PubInv/tetrobot/README.md

# gluss

An attempt to build metamorphic robots based on linear actuators. You probably want to go [https://pubinv.github.io/gluss/](https://pubinv.github.io/gluss) first.
