PubInv/tetrobot/doc/WaveletsForGluss.tex

\documentclass[11pt]{article}
\usepackage{geometry} % see geometry.pdf on how to lay out the page. There's lots.
\usepackage{hyperref}
\usepackage{graphicx}
\usepackage{gensymb}
\usepackage[affil-it]{authblk}
\usepackage[toc,page]{appendix}
\usepackage{pifont}
\usepackage{amsmath}
\usepackage{draftwatermark}
\usepackage{listings}

\SetWatermarkText{DRAFT}
\SetWatermarkScale{6}
\SetWatermarkLightness{0.95}

% \geometry{letter} % or letter or a5paper or ... etc
% \geometry{landscape} % rotated page geometry

% See the ``Article customise'' template for come common customisations

\title{Wavelets for Gluss Robots}
\author{Robert L. Read
  \thanks{read.robert@gmail.com}
}
\affil{Founder, Public Invention, an educational non-profit.}

\date{\today}

%%% BEGIN DOCUMENT
\begin{document}

\maketitle

%% \tableofcontents

\section{Introduction}

This is a draft of an attempt to apply wavelet technology to gluss.
However, it may touch on pure and applied mathematics in different valuable ways.
\begin{itemize}  
\item We will argue that wavelet and Fourier transforms should be reformulated to
  accept the possibility a function being undefined at various points. Possibly we will
  learn later that this is wrong, but must provide a means of dealing with it.
\item We will argue that the tendency to treat solid objects as a curved surface in 3-space
  is insufficient for the specific purpose of mapping abstractly from objects to gluss gaits
  and for doing form-matching in three space.
\item We will argue that wavelets provide an ideal way to define gaits for robots,
  not as a transform, but as the original means for constructing and representing them.
\item We will argue that wavelets provide a means of matching solid shapes in both space and time.
\end{itemize}  

\section{Solid Shape Matching Via Wavelets}

A fundamental problem posed by an attempt to create a metamorphic material is how to specify and controls
its shape in both space and time. Ordinarily we would refer to the change in shape over time as a ``gait''
if its purpose is to locomote.

Gluss consists of a number of actuators connected by joints.  Likewise tensegrity robots might consist
of very numerous colletions of struts connected via cables. Whether we consider a moving robot or
a static structure, we would like to conveniently compute a configure of a such machines to match
any solid shape.

It is typical to operate in terms of surfaces. However, we argue it is far better to use three-dimensional
objects directly. It is entirely reasonable to create a general shape in 3-space as a collection of
objects which are not in fact in any way connected, and yet still compute a matching shape of a
connected gluss.  Or, if dealing with a robot swarm, we might even relax the constraint that the result
be connected.

Our fundamental problem is to compute a mapping from what we might call the ``Blob Space'', $\mathcal{B}$, into
the ``Gluss Space'', $\mathcal{G}$. The properties of the the Blob Space are:
\begin{itemize}  
\item It should be really easy for human beings to design objects in $\mathcal{B}$.
\item It should be easy to import representations of objects into $\mathcal{B}$.
\item It should be easy to animate objects in $\mathcal{B}$ without constraints imposed by
  the physical world.  For example, motion need not be continuous and mass need not be conserved.
\item It is untainted by any notion of scale.
\end{itemize}  

The Gluss Space, on the other hand:
\begin{itemize}  
\item Imposes strict limitations on geometry to match the physical limitations of actual robots.
\item An object in $\mathcal{G}$ can be directly implemented with a simulation or a physical robot.
\item Furthermore time may have limits as well. Motion in $\mathcal{G}$ must be continuous, and
  might have to be slow.
\end{itemize}  

Let us consider an example.  We wish to explore the possibility of making a gluss-style robot
walk to  building and crawl through a window. This is requires locomotion, elevation, and
potentially decreasing the size of the robot to fit the window.  Even if the glussbot can
jump through the window, it must potentially deal with these issues, and we may plausible
assume that it will crawl through the window instead, like a worm.

It would be convenient to model the gluss bot as 6 or 7 spheres in $\mathcal{B}$ of the same size.
These need not really be connected, they should just be close enough that they generally form
a stout worm, or grub-like, shape.  Then we develop a short series of steps on $\mathcal{B}$, not
even a smooth animation, that suggests getting through the window. Let us imagine 10 such steps.
This could probably be done in 3 minutes using a mouse and some javascript code.

Then we want to specify a Gluss Space matching a glussbot we actually have. We would like
to automatically map the Blob Space steps into a Gluss Space motion that potentially gets our
glussbot through the window.

It is possible that work done in animation will assist us greatly in this already; I need
to research that.

Assuming this is not already a solved problem, I claim that 3D wavelets are the best way
to approach the mapping problem.

A second example.  In order to give wonder to a child, we want to order our glussbot to
assume the shape of a lion. We import an .stl file into the Blob Space.  But we have a highly
constrained gluss bot.  We have to figure out how to order it to approximate the lion shape.
This problem could be approached as a problem of conformity to an outside surface, but I think
it will be easier when approached as a problem of matching masses described as 3D wavelets.

\subsection{On the problem of 3D wavelets}

I suspect it is an open question how to best define 3D wavelets.
As always, wavelet choice is a design spectrum that depends on the algorithms you wish to use.

It seems to me the fundamental question is whether a wavelet should represent a density function,
upon which a isovalued surface defines solidity, or if it should be digital, having a hard surface.

If it has a hard surface, how do we create negative wavelets?  Dare we use some analog of complex
numbers?  And is this really a 3D problem after all?  If we deal with the problem of undefined
values in a 1-D signal, we have the same problem.

I can imagine that it is intellectually quite interesting to try to design good 3D wavelets.
Indeed even 2D.  Imagine in 2D that we wish to represent not IMAGES but DRAWINGS.

\section{On a human algebra of Wavelets for Gaits}

It is important to understand that it is painful to define gaits in general. Although
it seems mathematical, it may actually be much easier to define an Abelian algebra over gaits,
so that gaits (or wavelet gaits) can be composed by an operation that we call ``addition''.

For example, we want to say to a dancer: ``Walz with the same steps, but hold your hands
above your head.'' This requires the dancer to subtly adjust their gait, such that an observer
might not even notice.  If we say to a gluss: ``hold the baby and carry it to safety'', we
may imagine that to be a radical change to the gait.  Simple composition may not be sufficient.

Nonetheless we should seek a simple composition of gaits.
Untitled event
What seems like a simple approach is to define a gait as a set of wavelets in the space
of actuator controls.  That is, a 12-dimensional space, in the case of the 3TetGlussBot.

\section{On the problem of controlling a gluss}

When the number of actuators in a gluss is measured in 10s, it is reasonable to build a computer simulation
that drags actuators, nodes, of the centroids of tetrahedra to directly.
Eventually, however, we need to control the gluss with manipulation of a simpler system.
For example, we would like to control a tentacle with 8 control nodes, independent of the scale of the
gluss implementing it.

I believe a reasonable approach here is to write an algorithm that takes a model in the ``Blob Space''
and computes a configuration in the ``gluss space''.

Here is such an algorithm (2-D Algorithm, easily generalized):

\begin{lstlisting}
  F(Model,Ape) {
    CM = Centroid(Model);
    If Ape has one triangle or less:
    Attach springs from each node to the centroid of Model
    Else:
    AM = Centroid(Ape);
    MomApe = Moment(Ape);
    MomMod = Moment(Model);
    ApeBifurcationLine = PerpendicularMidpointLine(AM,MomApe);
    ModBifurcationLine = PerpendicularMidpointLine(CM,MomMod);
    return Union(F(Top(Model,ModBifurcationLine),Top(Ape,ApeBifurcationLine)),
                 F(Bot(Model,ModBifurcationLine),Bot(Ape,ModBifurcationLine)));
  }
\end{lstlisting}

The basic ideas is that this computes a set of springs, which when computed by a physics engine, should
do a pretty good job Aping the model with Gluss space with a configuration of the Ape.

I'm not too happy with this as an algorithm. It is not that easy to say very much meaningful about it.
I would like to create an error metric, and prove a relationship between the Error(F(Model,Ape),Model).

I believe it is possible to create an analog of wavelets to allow multiresolution computation, but
have not yet been able to produce any particularly valuable result.

\section{On interesting Dyanmics}

This section probably has nothing to do with dynamics, it is just an interesting idea.

Suppose that we have a gluss system, in the form of tentacle.  Let's imagine it is just in two
dimensions for now.

How fast can we launch a payload? How fast can we throw something?

Note that we can think of this problem in terms of kinematics (which is kind of a cheap shot,
and unlikely to be successful) just based on the motion of the actuators, assuming they are always
strong enough to produce the velocities in question.

Or we can work on it from the point of view of dynamics, which makes it much more interesting.

A gluss tentacle that could toss things would be pretty astounding.

\section{Thoughts on Wavelets}

Over the week will traveling I made a number of attempts to develop a theory of
Blob Spaces.

There are several approaches:
\begin{itemize}  
\item We can create a ``moment-based'' system.
\item We can try to build a ``simplex'' based system that uses triangles/tetrahedra.
\item We can beuild an ``extent-based'' system.
\end{itemize}

I made copious notes with many ideas but came to no particular conclusion.
However, I am convinced that we need a software toolchain and that the basic ideas of
Blob theory are needed.

Note that I need to do a lot more research in animation to understand this.

My notes suggest that there are rich possibilities, but I found no crisp
theorems or ideas.

One idea is to separate the physical interpretation from the data space.

Resarch ``Fresh'' and 2D animation.
3D Animation seems to be done with Blender or ``Maya'' and rigging and keyframes.
Motion Graphics is next form.

\end{itemize}  

\end{document}
