PubInv/tetrobot/doc/TurretJointPieces.pdf

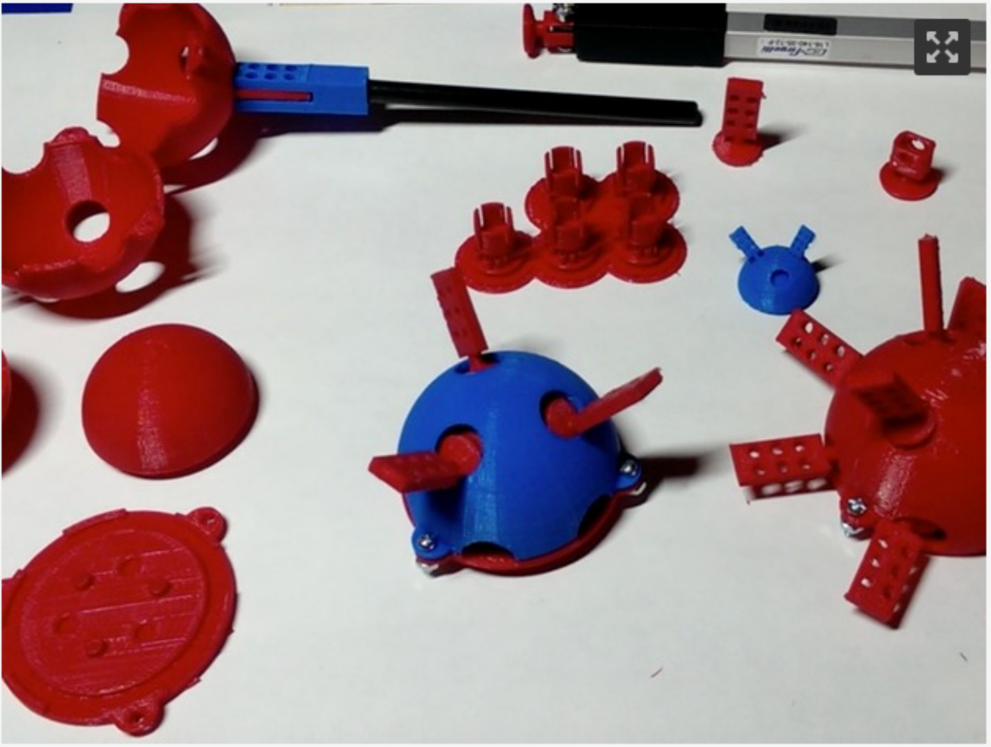
[picture p31: page 1]
