PubInv/tetrobot/doc/5TetGlussBotPictures/DSC_0990.JPG

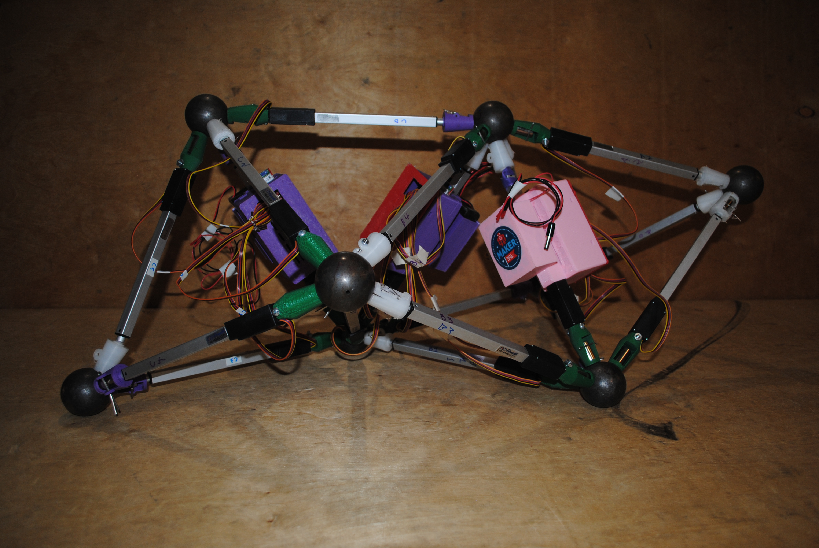
doc/5TetGlussBotPictures/DSC_0990.JPG
