PubInv/tetrobot/doc/5TetGlussBotPictures/DSC_0991.JPG

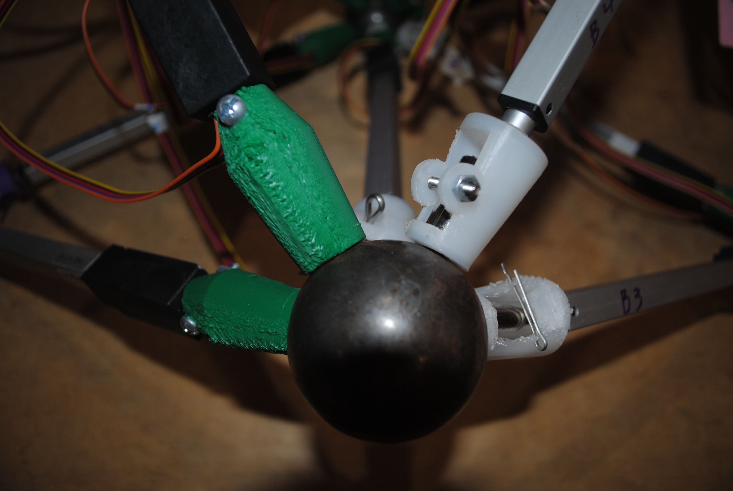
doc/5TetGlussBotPictures/DSC_0991.JPG
