PubInv/tetrobot/doc/5TetGlussBotPictures/DSC_0992.JPG

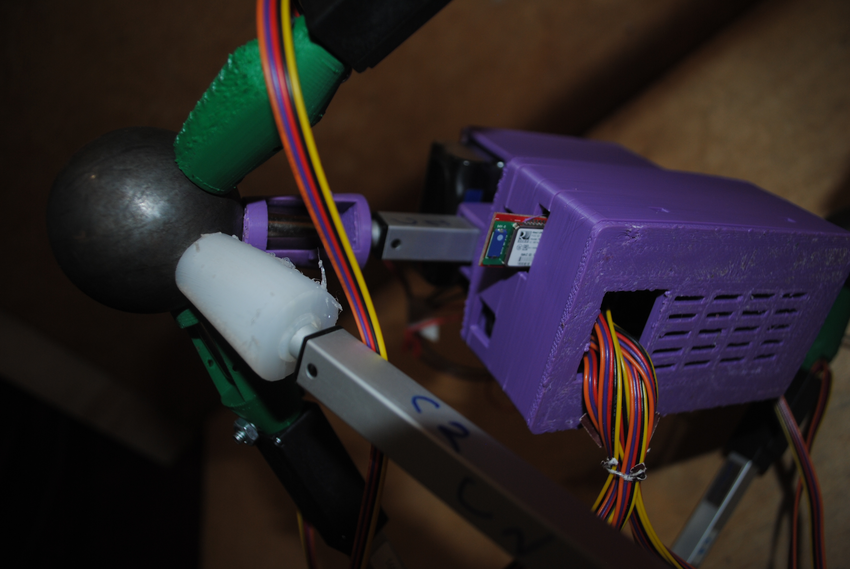
doc/5TetGlussBotPictures/DSC_0992.JPG
