PubInv/tetrobot/doc/5TetGlussBotPictures/DSC_0994.JPG

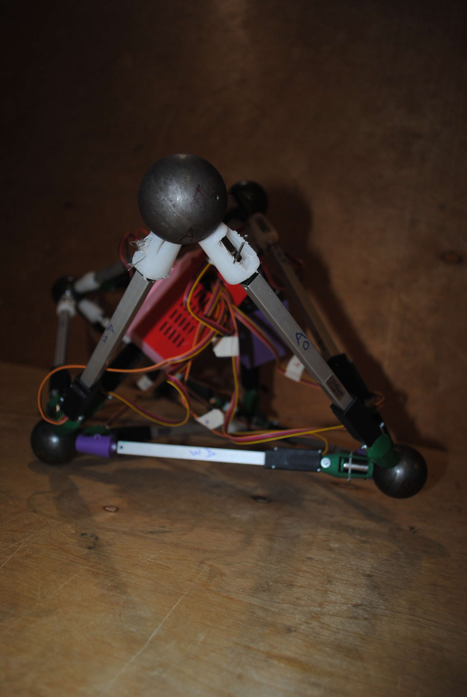
doc/5TetGlussBotPictures/DSC_0994.JPG
