PubInv/tetrobot/doc/5TetGlussBotPictures/DSC_0996.JPG

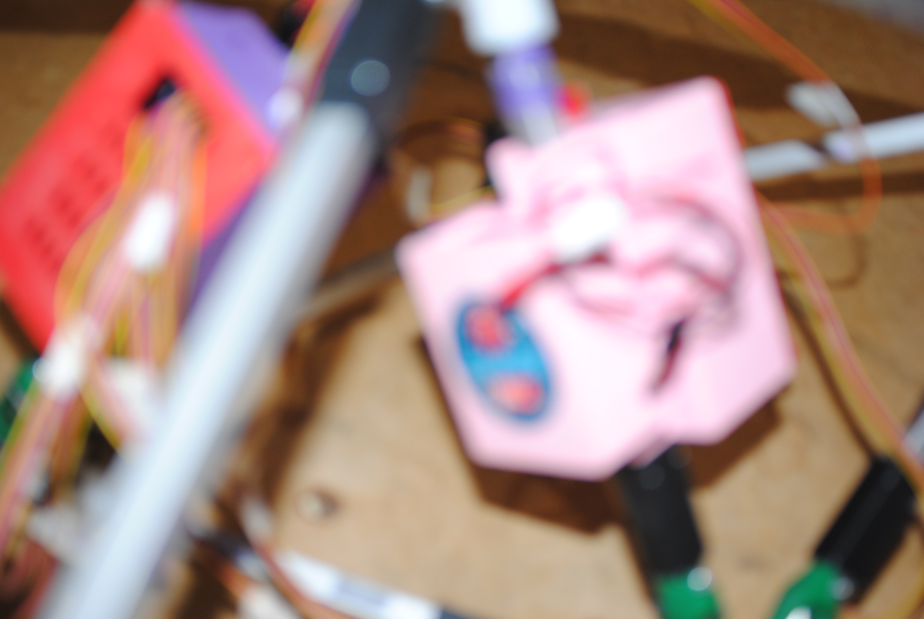
doc/5TetGlussBotPictures/DSC_0996.JPG
