PubInv/tetrobot/doc/5TetGlussBotPictures/DSC_0998.JPG

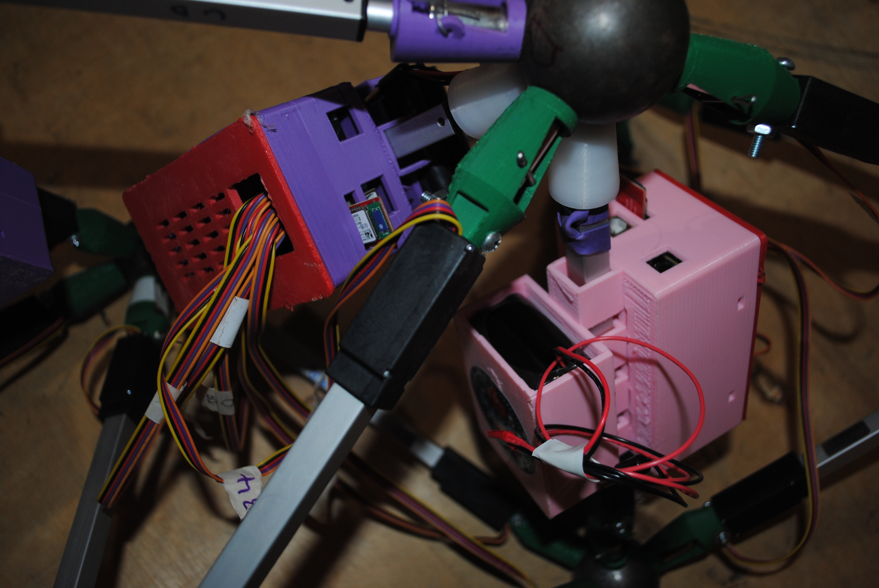
doc/5TetGlussBotPictures/DSC_0998.JPG
