PubInv/tetrobot/doc/Coxeter_helix_3_colors_cw.png

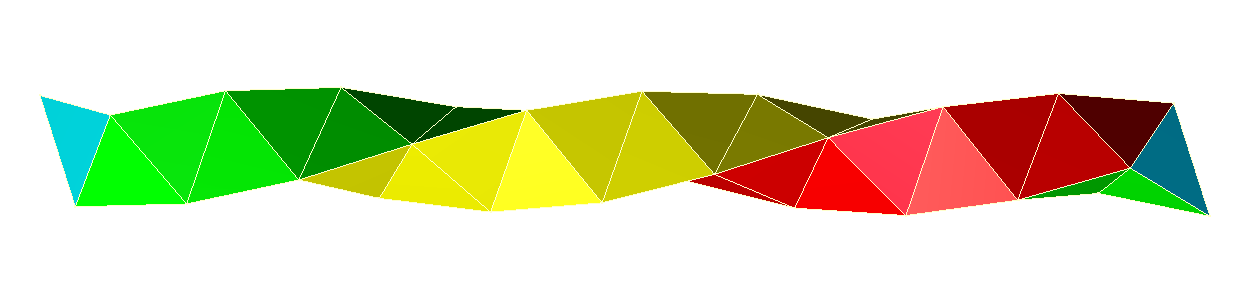
doc/Coxeter_helix_3_colors_cw.png
