PubInv/tetrobot/doc/figures/Tetrahelix0.png

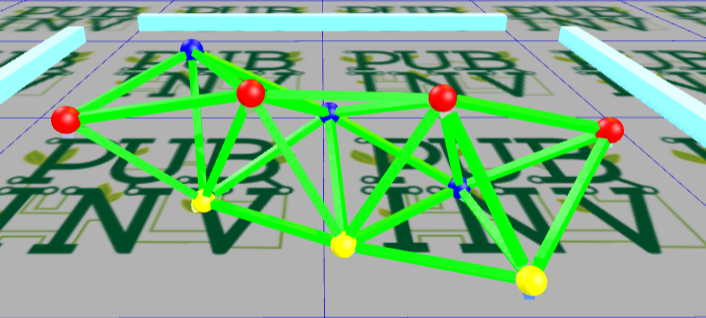
doc/figures/Tetrahelix0.png
