PubInv/tetrobot/doc/figures/Tetrahelix1.png

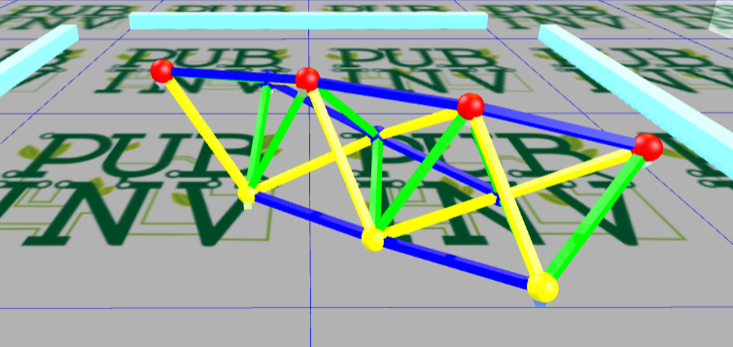
doc/figures/Tetrahelix1.png
