PubInv/tetrobot/doc/figures/Tetrahelix2.png

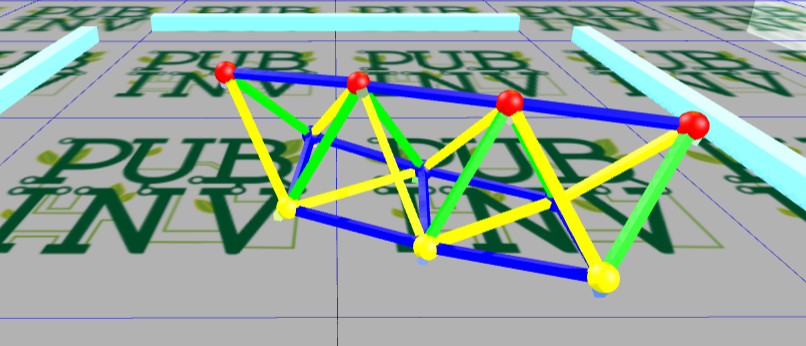
doc/figures/Tetrahelix2.png
