PubInv/tetrobot/doc/figures/Tetrahelix3.png

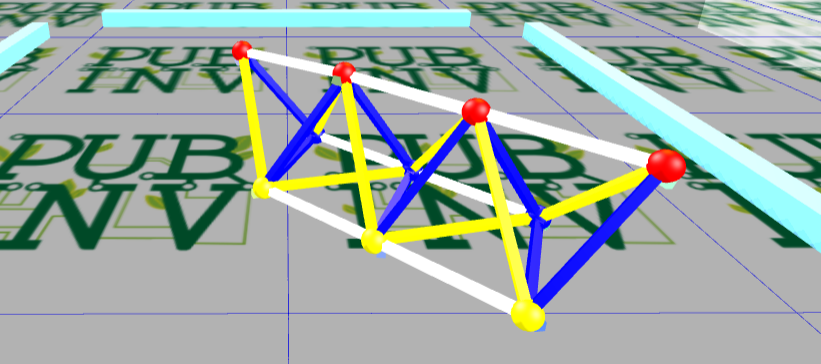
doc/figures/Tetrahelix3.png
