PubInv/tetrobot/doc/figures/TetrahelixColoringDiagram.png

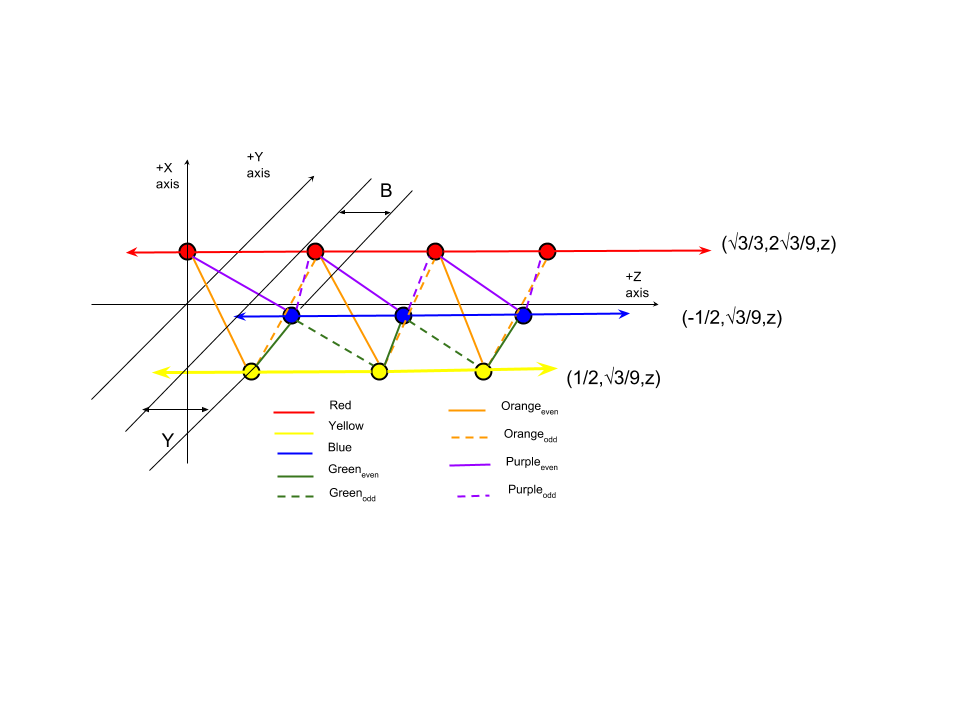
doc/figures/TetrahelixColoringDiagram.png
