PubInv/tetrobot/doc/Kwon, Song, Kim Screenshot.png

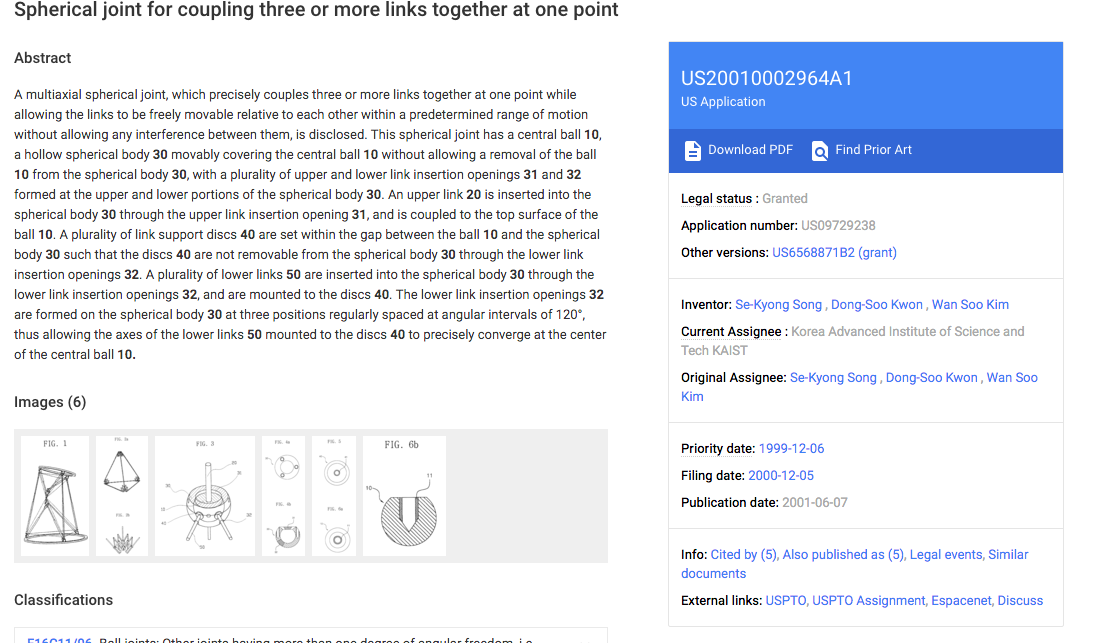
doc/Kwon, Song, Kim Screenshot.png
