PubInv/tetrobot/doc/TetrahelixColoringDiagram.png

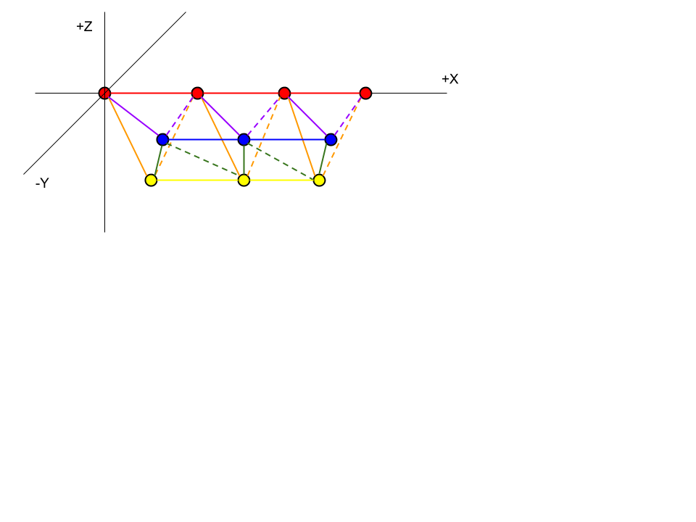
doc/TetrahelixColoringDiagram.png
