PubInv/tetrobot/doc/TurretJointMath.png

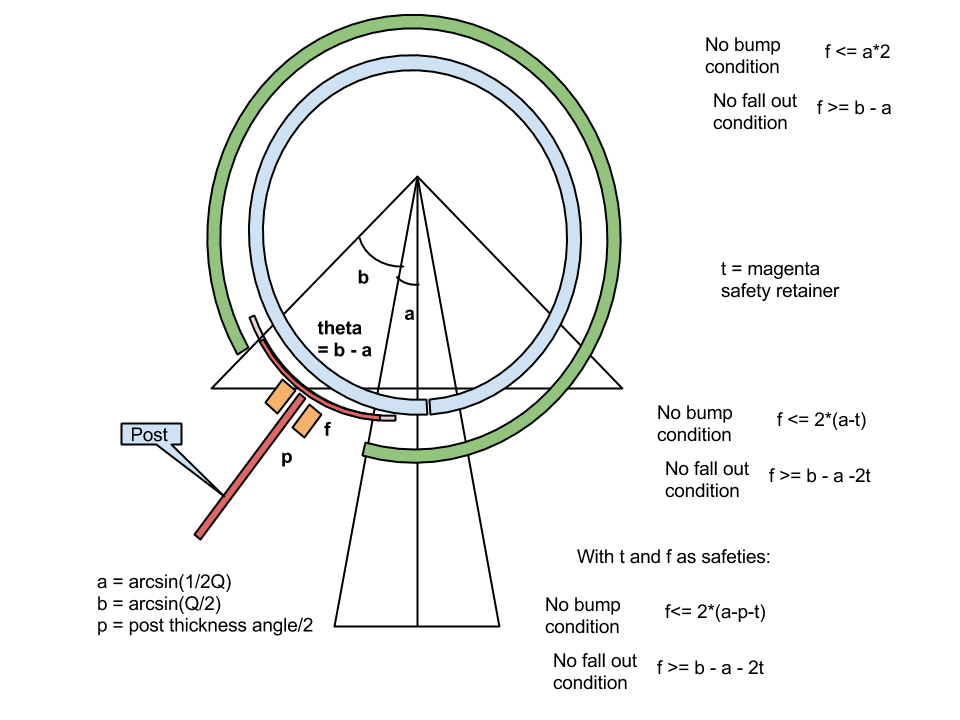
doc/TurretJointMath.png
