PubInv/tetrobot/MegaAndShieldEnclosure/Try2.stl

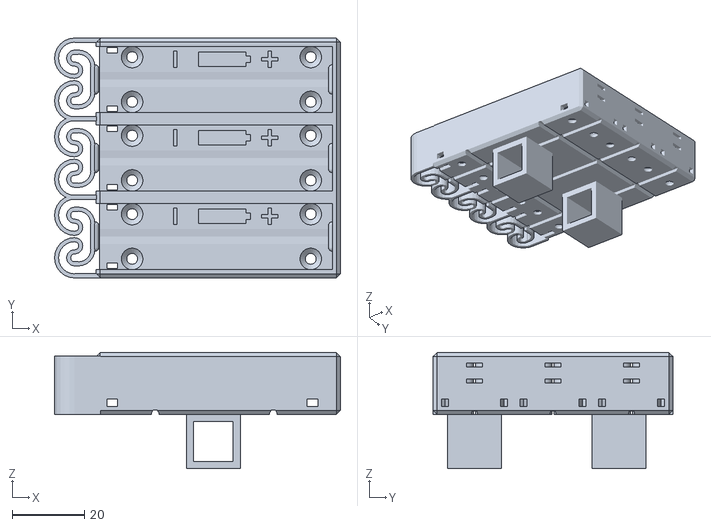
[picture p47: CAD file, 2017-03-30]
MegaAndShieldEnclosure/Try2.stl
79.3 x 66.5 x 32.2
