PubInv/tetrobot/MegaAndShieldEnclosure/combined_enclosure.stl

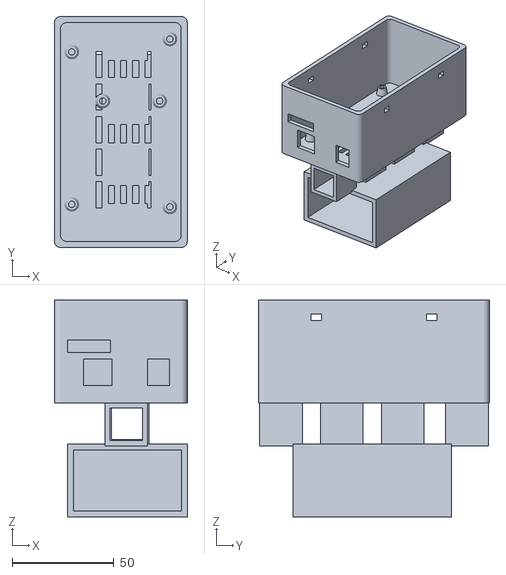
[picture p48: CAD file, 2017-03-30]
MegaAndShieldEnclosure/combined_enclosure.stl
65.5 x 113.6 x 106.7
