PubInv/tetrobot/MegaAndShieldEnclosure/EnclosureLid.stl

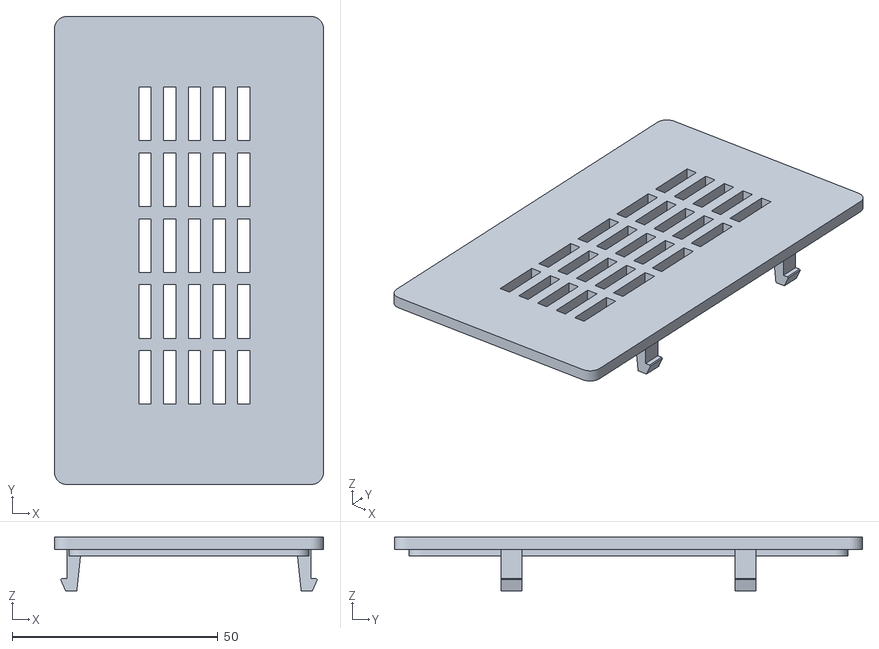
[picture p49: CAD file, 2017-03-30]
MegaAndShieldEnclosure/EnclosureLid.stl
65.3 x 113.6 x 13.0
