PubInv/tetrobot/MegaAndShieldEnclosure/BatteryCase.stl

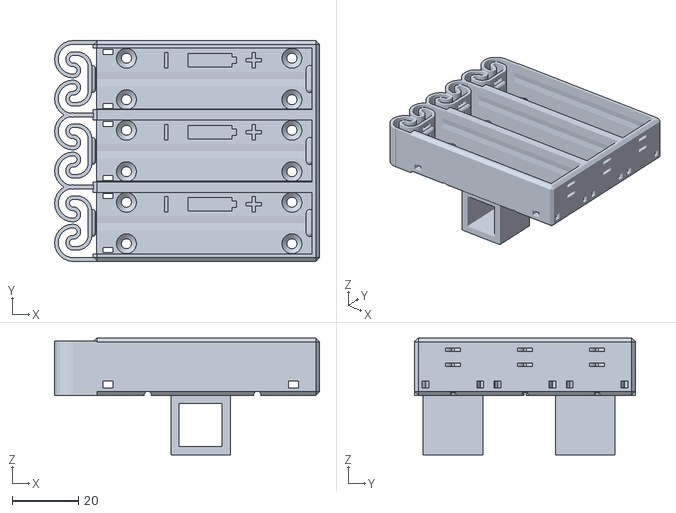
[picture p50: CAD file, 2017-03-30]
MegaAndShieldEnclosure/BatteryCase.stl
80.1 x 66.7 x 35.3
