PubInv/tetrobot/MegaAndShieldEnclosure/LidWPort.stl

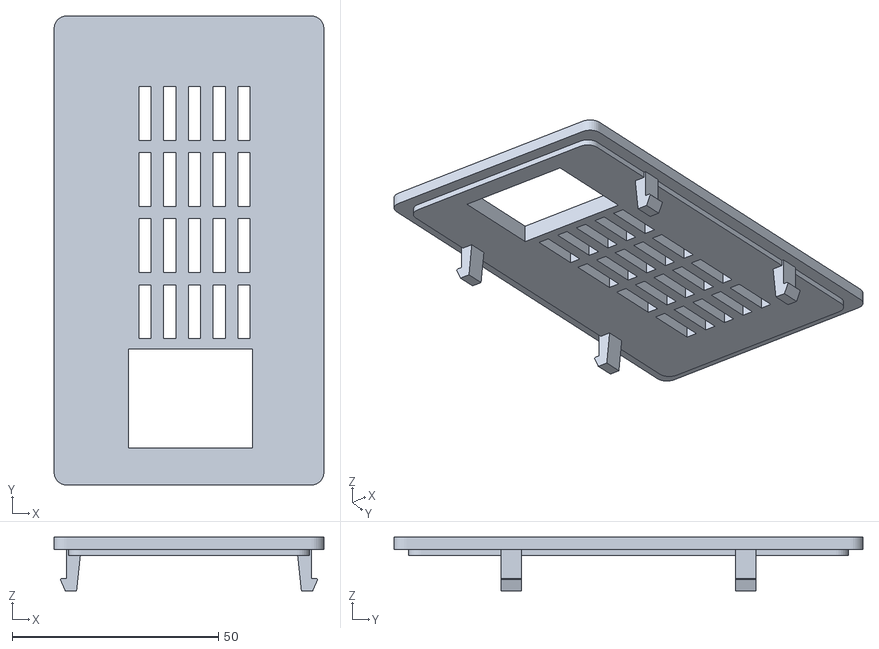
[picture p51: CAD file, 2017-03-30]
MegaAndShieldEnclosure/LidWPort.stl
65.3 x 113.6 x 13.0
