PubInv/tetrobot/MegaAndShieldEnclosure/firg-flexbatter.stl

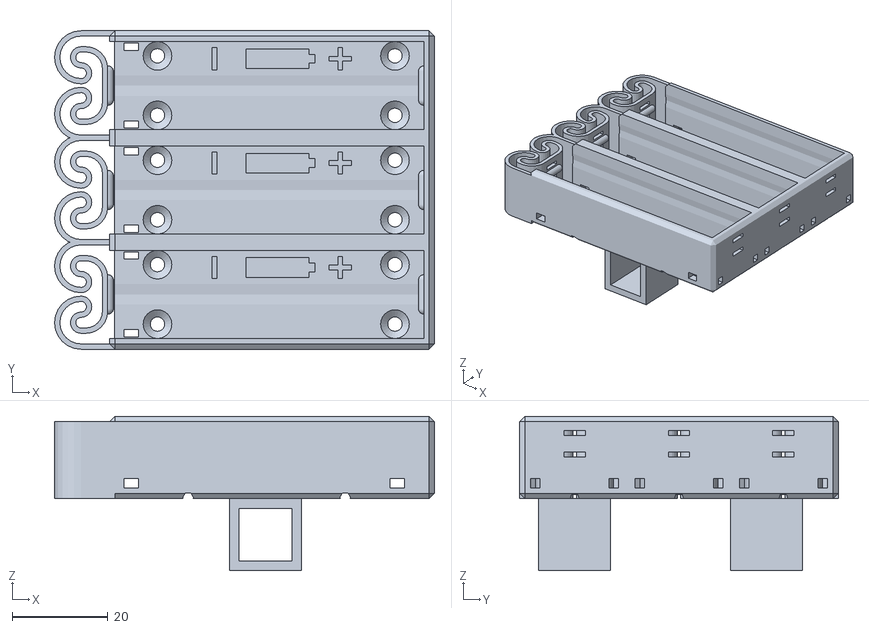
[picture p52: CAD file, 2017-03-30]
MegaAndShieldEnclosure/firg-flexbatter.stl
79.2 x 66.4 x 32.2
