PubInv/tetrobot/MegaAndShieldEnclosure/NiMhHolder.stl

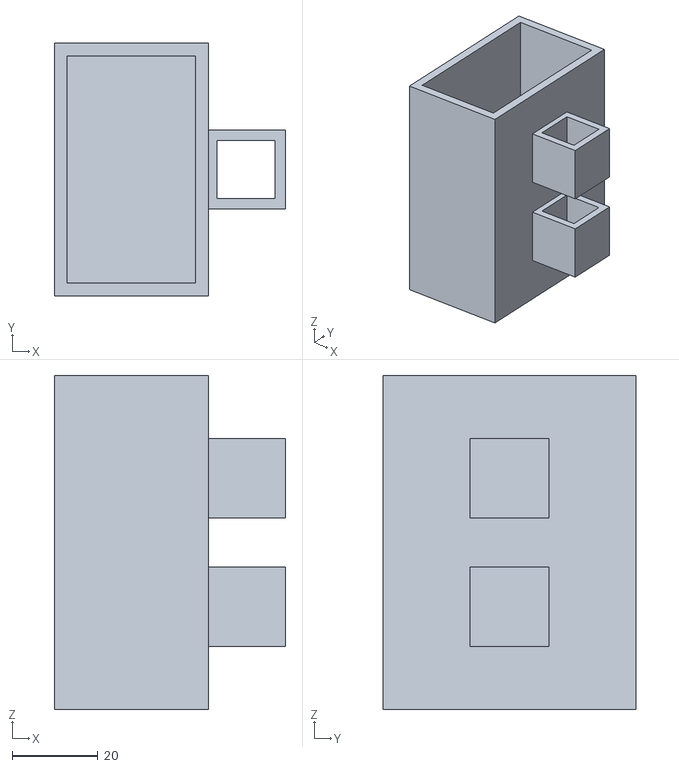
[picture p53: CAD file, 2017-03-30]
MegaAndShieldEnclosure/NiMhHolder.stl
54.0 x 59.0 x 78.0
