PubInv/tetrobot/MegaAndShieldEnclosure/EnclosureWithShield.stl

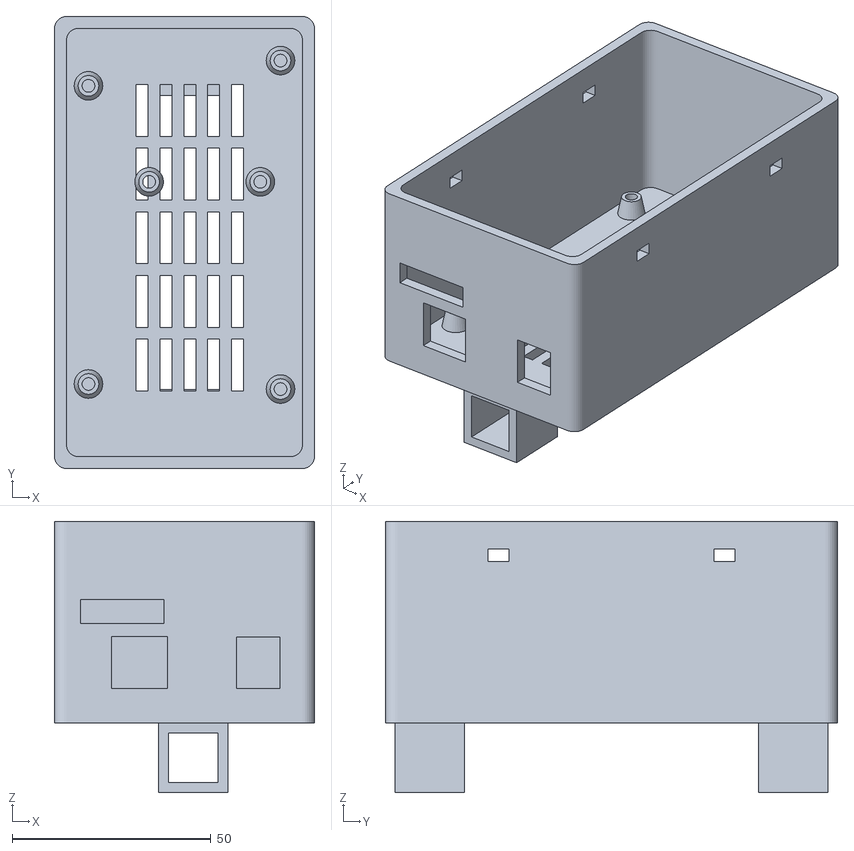
[picture p54: CAD file, 2017-03-30]
MegaAndShieldEnclosure/EnclosureWithShield.stl
65.3 x 113.6 x 68.2
