PubInv/tetrobot/MegaAndShieldEnclosure/CaseBracket.stl

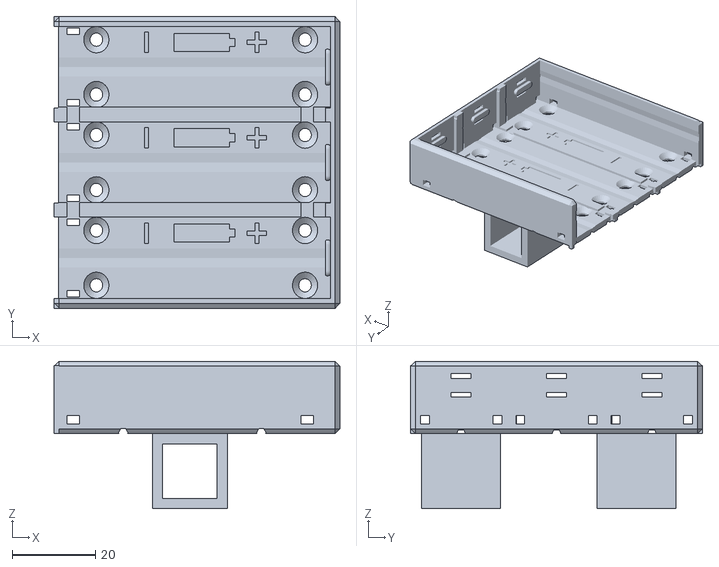
[picture p55: CAD file, 2017-03-30]
MegaAndShieldEnclosure/CaseBracket.stl
68.4 x 70.0 x 35.3
