PubInv/tetrobot/(list of files, cad)

Other CAD files:
MegaAndShieldEnclosure/combined_enclosure.scad
