PubInv/tetrobot/GlussPCBv0.1/Mega_Shield-v13-VertPlace7.brd

## EAGLE design GlussPCBv0.1/Mega_Shield-v13-VertPlace7.brd (2017-03-30)

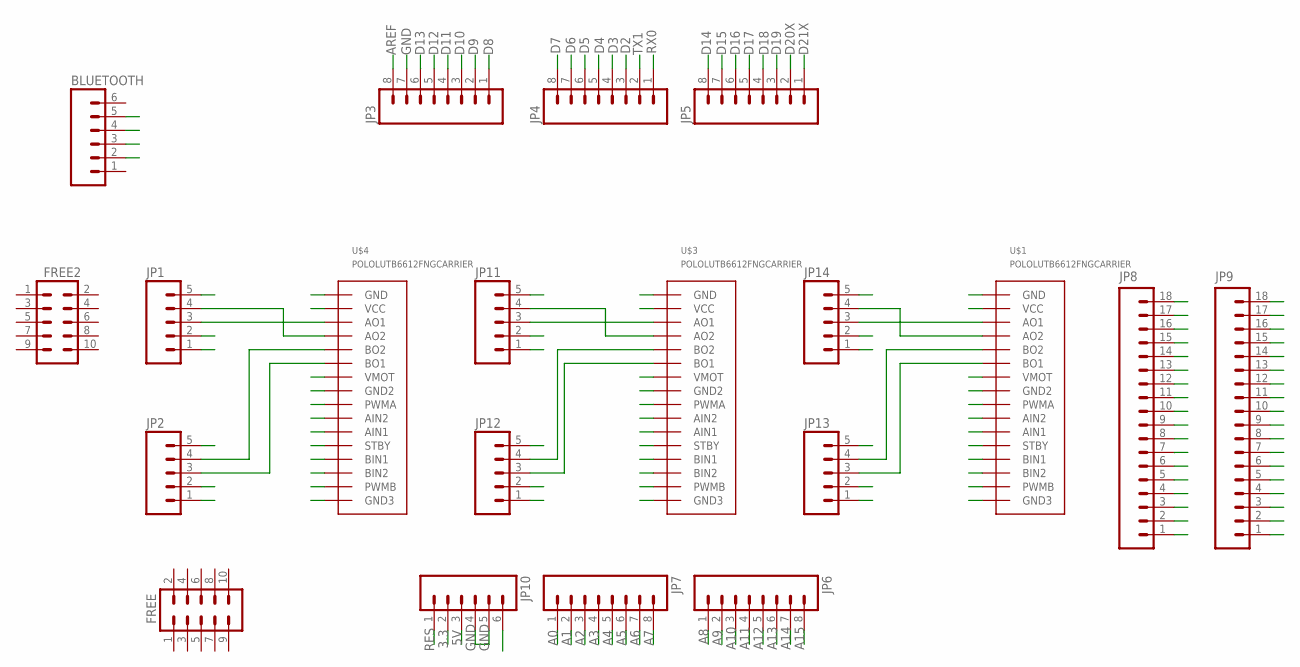
[picture p56: schematic Mega_Shield-v13-VertPlace7.sch]

Parts:
BLUETOOTH: M06FEMALE_LOCK; 1X06_FEMALE_LOCK.010
FREE, FREE2: M05X2NO_SILK; 2X5_NOSILK
JP1, JP2, JP11, JP12, JP13, JP14: M05LOCK; 1X05_LOCK
JP3, JP4, JP5, JP6, JP7: M08LOCK; 1X08_LOCK
JP8, JP9: M18_; 1X18
JP10: M06LOCK; 1X06_LOCK
U$1, U$3, U$4: POLOLUTB6612FNGCARRIER; THROUGHHOLECARRIER

Connections:
3.3: JP10.2
5V: BLUETOOTH.5, JP1.5, JP2.5, JP8.18, JP9.18, JP10.3, JP11.5, JP12.5, JP13.5, JP14.5, U$1.2 (VCC), U$1.12 (STBY), U$3.2 (VCC), U$3.12 (STBY), U$4.2 (VCC), U$4.12 (STBY)
A0: JP7.1, JP14.2
A1: JP7.2, JP13.2
A2: JP7.3, JP11.2
A3: JP7.4, JP12.2
A4: JP1.2, JP7.5
A5: JP2.2, JP7.6
A6: JP7.7
A7: JP7.8
A8: JP6.1
A9: JP6.2
A10: JP6.3
A11: JP6.4
A12: JP6.5
A13: JP6.6
A14: JP6.7
A15: JP6.8
AREF: JP3.8
D2: JP4.3, U$1.9 (PWMA)
D3: JP4.4, U$1.15 (PWMB)
D4: JP4.5, U$3.9 (PWMA)
D5: JP4.6, U$3.15 (PWMB)
D6: JP4.7, U$4.9 (PWMA)
D7: JP4.8, U$4.15 (PWMB)
D8: JP3.1
D9: JP3.2
D10: JP3.3
D11: JP3.4
D12: BLUETOOTH.2, JP3.5
D13: BLUETOOTH.3, JP3.6
D14: JP5.8
D15: JP5.7
D16: JP5.6
D17: JP5.5
D18: JP5.4
D19: JP5.3
D20X: JP5.2
D21X: JP5.1
D22: JP8.17
D23: JP9.17
D24: JP8.16
D25: JP9.16
D26: JP8.15
D27: JP9.15
D28: JP8.14
D29: JP9.14
D30: JP8.13
D31: JP9.13
D32: JP8.12
D33: JP9.12
D34: JP8.11
D35: JP9.11
D36: JP8.10
D37: JP9.10
D38: JP8.9
D40: JP8.8
D41: JP9.8
D42: JP8.7, U$4.14 (BIN2)
D43: JP9.7, U$4.13 (BIN1)
D44: JP8.6, U$4.10 (AIN2)
D45: JP9.6, U$4.11 (AIN1)
D46: JP8.5, U$3.14 (BIN2)
D47: JP9.5, U$3.13 (BIN1)
D48: JP8.4, U$3.10 (AIN2)
D49: JP9.4, U$3.11 (AIN1)
D50: JP8.3, U$1.14 (BIN2)
D51: JP9.3, U$1.13 (BIN1)
D52: JP8.2, U$1.10 (AIN2)
D53: JP9.2, U$1.11 (AIN1)
GND: BLUETOOTH.4, JP1.1, JP2.1, JP3.7, JP8.1, JP9.1, JP10.4, JP10.5, JP11.1, JP12.1, JP13.1, JP14.1, U$1.1 (GND), U$1.8 (GND2), U$1.16 (GND3), U$3.1 (GND), U$3.8 (GND2), U$3.16 (GND3), U$4.1 (GND), U$4.8 (GND2), U$4.16 (GND3)
unnamed: JP14.3, U$1.3 (AO1)
unnamed: JP14.4, U$1.4 (AO2)
unnamed: JP13.3, U$1.6 (BO1)
unnamed: JP13.4, U$1.5 (BO2)
unnamed: JP11.3, U$3.3 (AO1)
unnamed: JP12.3, U$3.6 (BO1)
unnamed: JP12.4, U$3.5 (BO2)
unnamed: JP11.4, U$3.4 (AO2)
unnamed: JP1.3, U$4.3 (AO1)
unnamed: JP1.4, U$4.4 (AO2)
unnamed: JP2.3, U$4.6 (BO1)
unnamed: JP2.4, U$4.5 (BO2)
RES: JP10.1
RX0: JP4.1
TX1: JP4.2
VIN: JP10.6, U$1.7 (VMOT), U$3.7 (VMOT), U$4.7 (VMOT)

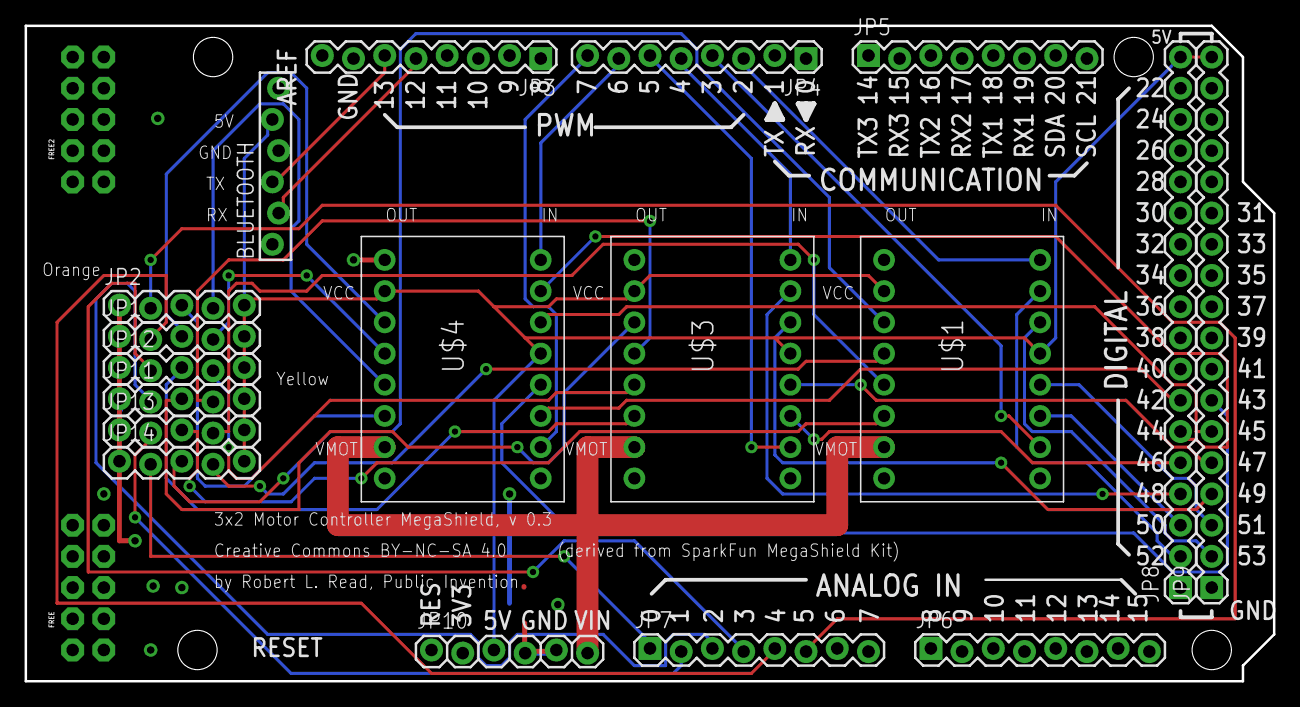
[picture p57: board Mega_Shield-v13-VertPlace7.brd from above]

Board: 2 copper layers, 101.6 x 53.3 mm, 20 parts (0 on the bottom side), 41 nets.
