PubInv/tetrobot/GlussPCBv0.1/GlussPCBv0.1.ino

#include <TaskScheduler.h>

#include "S-Expr.h"
#include "Arduino.h"
#include <stdlib.h>
#include <SoftwareSerial.h>
#include <math.h>
#include <assert.h>
#include "FirgAct.h"




int sign(int a) {
  return (a < 0) ? -1 : ((a == 0) ? 0 : 1); 
}

// Overall maximum speed: This can be used to limit amperage
const float MAX_AMPS = 3.6;
const float STALL_CURRENT_AMPS = 0.6;

// typedef struct actuator Actuator;
const int NUM_ACTUATORS = 6;

const int MAX_SPEED = (MAX_AMPS/(STALL_CURRENT_AMPS*NUM_ACTUATORS)) * 255;

// Chosen to deal with duty cycle
const int CRUISE_SPEED = MAX_SPEED;

actuator act[NUM_ACTUATORS];

// This is the only set of pints that seems to work!
// I am very confused by this.
const byte bluetoothTx = 12;
const byte bluetoothRx = 13;

SoftwareSerial bluetooth(bluetoothRx, bluetoothTx);

// const String BLUETOOTH_BAUD_RATE = 9600;

// Note:  This requires special syntax, must be precise!

// This doesn't seem to work....sadly. Not sure if to fast or some other problem
 const int BLUETOOTH_BAUD_RATE = 19200;
 const String BLUETOOTH_BAUD_RATE_STRING = "19.2";

// Note: These work....
// const int BLUETOOTH_BAUD_RATE = 19200;
// const String BLUETOOTH_BAUD_RATE_STRING = "19.2";
//const long BLUETOOTH_BAUD_RATE = 115200;
//const String BLUETOOTH_BAUD_RATE_STRING = "115K";
  
const int DEBUG = 5;
const int INFORM = 4;
const int WARN = 3;
const int ERROR = 2;
const int PANIC = 1;

int DEBUG_LEVEL = WARN;

int num_responsive = 0;

int responsive[NUM_ACTUATORS];

String Current_Call_Id = "";
String command_failure = "";


// NOTE: It is important to have sufficient battery power. The actuators don't move
// This is desirable because we want to make
// sure that any debug statements are prefixed
// with comment characters.

void log_comment(int level,Stream* debug,String str) {
  if (level <= DEBUG_LEVEL) {
    debug->print(";; ");
    debug->println(str);
  }
}

// I don't know why this is needed
void log_comment_i(int level,Stream* debug,int i) {
  if (level <= DEBUG_LEVEL) {
    debug->print(";; ");
    String s = "";
    s = s + i;
    debug->println(s);
  }
}
// if you don't have sufficient battery power. It is impossible to tell if things
// are actuators are responsive if you do not have enough battery power.

int freeRam () 
{
  extern int __heap_start, *__brkval; 
  int v; 
  return (int) &v - (__brkval == 0 ? (int) &__heap_start : (int) __brkval); 
}



// 1 means extend, -1 means restract
void activate_actuators(int actuator,int direction,int strength)
{
  if (act[actuator].responsive) {
    analogWrite(act[actuator].speedPin,strength);
    if (direction == 1) {
      digitalWrite(act[actuator].reversePin,LOW);
      digitalWrite(act[actuator].forwardPin,HIGH);  
    } else if (direction == -1) {
      digitalWrite(act[actuator].reversePin,HIGH);
      digitalWrite(act[actuator].forwardPin,LOW);  
    }
  }
}
void sensePositionVector(int n,int v[]);

// Note: We could construct and print an S-Expression here
// instead, but I see little value in that, and at presnt
// my sexpr library doesn't support the "dot" syntax.
void report_status(Stream* stream,String Current_Call_Id) {
    int cval[NUM_ACTUATORS];
    if (command_failure != "") {
      String err = "COMMAND_ERROR: " + command_failure;
      log_comment(PANIC,stream,err);
          stream->print("(status ");
	  stream->print("'COMMAND_ERROR");
	  stream->print(") ");
    }
    
    sensePositionVector(NUM_ACTUATORS, cval);
    stream->print("(status ");
    stream->print("(list ");
    if (!Current_Call_Id.equals("")) {
      stream->print("'");
      stream->print(Current_Call_Id);
      stream->print(" ");
    }
    for(int i = 0; i < NUM_ACTUATORS; i++) {
      stream->print("'( ");      
      stream->print(i);
      stream->print(" . ");
      if (act[i].responsive) {
	stream->print(cval[i]);
      } else {
	stream->print(" nil");
      }
      stream->print(") ");
    }
    stream->print("))");
    stream->println();
    int ram = freeRam();
  //  log_comment(PANIC,stream,"Free Mem");
  //  log_comment_i(PANIC,stream,ram);
}


int findByName(char c) {
  for(int i = 0; i < NUM_ACTUATORS; i++) {
    if (act[i].nm == c) {
      return i;
    }
  }
  Serial.println("NAME NOT FOUND");
  return -1;
}


void deactivate_actuator(int actuator) {
  digitalWrite(act[actuator].speedPin,LOW);
  digitalWrite(act[actuator].reversePin,LOW);
  digitalWrite(act[actuator].forwardPin,LOW);  
}

int sensePosition(int pin) {
  int val = analogRead(pin);
  return val;
}


void sensePositionVector(int n,int v[]) {
  for(int i = 0; i < n; i++) {
    v[i] = sensePosition(act[i].potPin);
  }
}

// This is probably obsolete
float dist3(int a[],int b[]) {
  float x = a[0];
  float y = a[1];
  float z = a[2];
  float q = b[0];
  float r = b[1];
  float s = b[2];
  return sqrt((x-q)*(x-q) + (y-r)*(y-r) + (z-s)*(z-s));
}

float dist_actuators(int n, int a[],int b[]) {
  float sum = 0.0;
  for(int i = 0; i < n; i++) {
    if (act[i].responsive) {
      float ai = a[i];
      float bi = b[i];
      sum += ((ai - bi)*(ai - bi));
    }
  }
  return sqrt(sum);
}

void relax(Stream *);

const int RESPONSE_THRESHOLD = 30;
const int RESPONSE_DELAY_TIME = 300;
void compute_responsiveness(Stream* debug) {

  int cval[NUM_ACTUATORS];
  int rval[NUM_ACTUATORS];  // retract val
  int eval[NUM_ACTUATORS];  // extent val
   
  relax(debug);
  sensePositionVector(NUM_ACTUATORS,cval);
  // Let's try to retract, and see if it moves. If it moves, either in retraction or contraction,
  // the we will mark it responsive. 
  for(int i = 0; i < NUM_ACTUATORS; i++) { 
    act[i].responsive = 0;                    // mark unresponsive
    activate_actuators(i,-1,CRUISE_SPEED);
  }
  delay(RESPONSE_DELAY_TIME);
  
  sensePositionVector(NUM_ACTUATORS,eval);
  
  for(int i = 0; i < NUM_ACTUATORS; i++) {
    if (act[i].responsive == 0) {   
      // We demand a positive motion 
      act[i].responsive = (((eval[i] - cval[i]) <= -RESPONSE_THRESHOLD) ? 1 : 0);
      log_comment(DEBUG,debug,"SPUDX");
      log_comment_i(DEBUG,debug,i);
      log_comment_i(DEBUG,debug,eval[i] - cval[i]);
      log_comment_i(DEBUG,debug,((eval[i] - cval[i]) <= -RESPONSE_THRESHOLD) ? 1 : 0);
    }
  }  
  
  for(int i = 0; i < NUM_ACTUATORS; i++) {    
    activate_actuators(i,1,CRUISE_SPEED);
  }
  delay(RESPONSE_DELAY_TIME);
  sensePositionVector(NUM_ACTUATORS,rval);
 
  for(int i = 0; i < NUM_ACTUATORS; i++) {
    deactivate_actuator(i);
  }

  
  for(int i = 0; i < NUM_ACTUATORS; i++) {   
    if (act[i].responsive == 0) {    
      act[i].responsive = (((eval[i] - rval[i]) >= RESPONSE_THRESHOLD) ? 1 : 0);
      log_comment(DEBUG,debug,"SPUDY");
      log_comment_i(DEBUG,debug,i);
      log_comment_i(DEBUG,debug,abs(eval[i] - rval[i]));
    }  
  }
  
}


void find_responsive(Stream* debug) {
  for(int i = 0; i < NUM_ACTUATORS; i++) { 
    act[i].responsive = 0;
  }
  compute_responsiveness(debug);
  int num_responsive = 0;
  for(int i = 0; i < NUM_ACTUATORS; i++) {
    log_comment_i(DEBUG,debug,i);
    //    debug->println(i);
    log_comment_i(DEBUG,debug,act[i].responsive);
  }
  
  for(int i = 0; i < NUM_ACTUATORS; i++) { 
    log_comment_i(DEBUG,debug,i);
    log_comment_i(DEBUG,debug,act[i].responsive);
    if (act[i].responsive == 1) {
      responsive[num_responsive++] = i;
    } else {
      log_comment(ERROR,debug,"ACTUATOR_UNRESPONSIVE:");
      log_comment_i(ERROR,debug,(char) act[i].nm);
      //   log_comment(debug,act[i].responsive);
    }
  }
  if (num_responsive != NUM_ACTUATORS) {
    log_comment(DEBUG,debug,"WE'VE GOT UNRESPONSIVE ACTUATORS");
    log_comment_i(DEBUG,debug,NUM_ACTUATORS - num_responsive);
  }
}

String EMPTY_STRING = "";

String gparam_for_sexpr_callback_str = EMPTY_STRING;
Stream* gparam_for_sexpr_callback_debug;


int r_cnt = 0;

void input_check_callback();
// void main_controller_callback();
void premove_processing();

Task t0(1,TASK_FOREVER, &input_check_callback);

// Task t1(1,TASK_FOREVER,&main_controller_callback);

Task t2(1,TASK_FOREVER,&premove_processing);


 const int tolerance = 50; // the maximum number of clicks in the "digital voltage space" of 0 - 1023 that we accept
  const float STUCK_DISTANCE = 1.0; // 3-Dimensional distance in the "digital voltage space" that we must move to not be "stuck"
  const int DELAY_TIME = 30; // Time to wait before making a move again
  const int MAX_STUCK = 4; // number of iterations to apply force before we give up as "stuck".
  const int MAX_TIME_MS = 4000;
  const int MAX_TURNS = MAX_TIME_MS / DELAY_TIME;

// I hate global parameters, but the task scheduler callbacks don't let me create thunks...

struct MVP {
    int *c_val;
    int *v;
    int *dir;
  
    bool in_position = false;
    int stuck_cnt = 0;
    int total_turns = 0;
    int *vec;
    int n;
    String Current_Call_Id;
};

MVP mvps;

void premove_processing() {
  unsigned long StartTime = millis();
  log_comment(DEBUG,gparam_for_sexpr_callback_debug,"PREMOVE XXX");
      
  if ((!mvps.in_position) && (mvps.stuck_cnt < MAX_STUCK) && (mvps.total_turns < MAX_TURNS)) {  
    mvps.total_turns++;
    log_comment_i(DEBUG,gparam_for_sexpr_callback_debug,mvps.total_turns);
    // Figure out which directions to move....
    sensePositionVector(mvps.n,mvps.c_val);
    int max_diff = -1;
    int d[mvps.n];
    for(int i = 0; i < mvps.n; i++) {
      if (act[i].responsive == 1) { // here we don't try to look for those that are unresponsive!
        d[i] = mvps.vec[i] - mvps.c_val[i];
        mvps.dir[i] = sign(d[i]);
        if (abs(d[i]) > max_diff)
          max_diff = abs(d[i]);
        }
    }

    log_comment(DEBUG,gparam_for_sexpr_callback_debug,"aaa");
    log_comment_i(DEBUG,gparam_for_sexpr_callback_debug,max_diff);
    for(int i = 0; i < mvps.n; i++) {  
      // This should probably adjust speed for those that 
      // need to move less  
      float speed_ratio = (float) abs(d[i]) / (float) max_diff;
      //      log_comment(DEBUG,debug,"activating");
      if (act[i].responsive == 1) { // don't move the unresponsive ones!
          activate_actuators(i,mvps.dir[i], (int) (speed_ratio * CRUISE_SPEED));
      } else {
          log_comment(DEBUG,gparam_for_sexpr_callback_debug,"unresponsive:");
          log_comment_i(DEBUG,gparam_for_sexpr_callback_debug,i);
      }
    }

    log_comment(DEBUG,gparam_for_sexpr_callback_debug,"bbb");
    // Wait a little bit for they physical move....
    // We need to split the function here and set the t1 callback to handle this...
      unsigned long EndTime = millis();
 //     log_comment_i(WARN,gparam_for_sexpr_callback_debug,EndTime - StartTime); 
    t2.delay(DELAY_TIME); 
    t2.setCallback(&postmove_processing);
  } else {
     if (mvps.total_turns >= MAX_TURNS) {
      log_comment(WARN,gparam_for_sexpr_callback_debug,"MOVE TIMED OUT!");
     }

    if (mvps.stuck_cnt >= MAX_STUCK) {
      log_comment(WARN,gparam_for_sexpr_callback_debug,"GOT STUCK!");
    }
    log_comment(DEBUG,gparam_for_sexpr_callback_debug,"about to deactivate");
    for(int i = 0; i < mvps.n; i++) {
      deactivate_actuator(i);
    }
    log_comment(INFORM,gparam_for_sexpr_callback_debug,"Move done!");
    t2.setCallback(&premove_processing);
    t2.disable();
    report_status(gparam_for_sexpr_callback_debug,mvps.Current_Call_Id);
  }
}

void postmove_processing() {
  if (!t2.isEnabled()) {
     for(int i = 0; i < mvps.n; i++) {
      deactivate_actuator(i);
    }
    return;
  }
    log_comment(DEBUG,gparam_for_sexpr_callback_debug,"POSTMOVE XXX");
    for(int i = 0; i < mvps.n; i++) {
      mvps.v[i] = mvps.c_val[i];     
    }
    sensePositionVector(mvps.n,mvps.c_val);
     
    log_comment(DEBUG,gparam_for_sexpr_callback_debug,"sense done");
    log_comment_i(DEBUG,gparam_for_sexpr_callback_debug,mvps.n);
     
    // if we didn't move at all, increase mvps.stuck_cnt, so we don't
    // permanently spin our motors with no progress
    if (dist_actuators(mvps.n,mvps.v,mvps.c_val) < STUCK_DISTANCE) {
      mvps.stuck_cnt++;
      log_comment(DEBUG,gparam_for_sexpr_callback_debug,"stuck!");
    } else {
      //     mvps.stuck_cnt = 0;
    } 
     
    mvps.in_position = true;
    for(int i = 0; i < mvps.n; i++) {
      if (act[i].responsive == 1) { // don't move the unresponsive ones!
        int computed = abs(mvps.c_val[i] - mvps.vec[i]);
        if (computed < tolerance) {
          deactivate_actuator(i);   
        } else {
          log_comment(DEBUG,gparam_for_sexpr_callback_debug,"Out of tolerance");
          String s = "";
          s = s + i + " " + computed;
          log_comment(DEBUG,gparam_for_sexpr_callback_debug,s);   
    //  log_comment(DEBUG,debug,computed);  
          mvps.in_position = false;
        }
      }
    }
    log_comment(DEBUG,gparam_for_sexpr_callback_debug,"end loop");  
    t2.setCallback(&premove_processing);
}
void move_vector(Stream* debug,int n,int *vec,String Current_Call_Id) {
 
  mvps.in_position = false;
  mvps.stuck_cnt = 0;
  mvps.total_turns = 0;
  delete(mvps.c_val);
  mvps.c_val = new int[n];
  delete(mvps.v);
  mvps.v = new int[n];
  delete(mvps.dir);
  mvps.dir = new int[n];
  delete(mvps.vec);
  mvps.vec = new int[n];
  mvps.n = n;
  mvps.Current_Call_Id = Current_Call_Id;
  for(int i = 0; i < n; i++) { mvps.vec[i] = vec[i];}

    log_comment(DEBUG,gparam_for_sexpr_callback_debug,"MOVE VECTOR");

  t2.setCallback(&premove_processing);
  t2.enable();

}

void send_all_to(Stream* debug,int val) {
  int vec[NUM_ACTUATORS];
  // First, lift
  for(int i = 0; i < NUM_ACTUATORS; i++) {
    vec[i] = val;
  }
  move_vector(debug,NUM_ACTUATORS,vec,Current_Call_Id);
}

void relax(Stream* debug) {
  send_all_to(debug,500);
}

void contract(Stream* debug) {
  send_all_to(debug,0);
}

void expand(Stream* debug) {
  send_all_to(debug,1023); 
}

void experiment(Stream* debug) {
  activate_actuators(0,-1,MAX_SPEED);
}



void OutputVector(Stream* stream,int n,int v[]) {
  for(int i = 0; i < n; i++) {
    stream->print(v[i]);
    stream->print(" ");
  }
}

void OutputVectorSerial(int n,int v[]) {
  OutputVector(&Serial,n,v);
}

void OutputVectorAsComment(int level,Stream* stream,int n,int v[]) {
   if (level <= DEBUG_LEVEL) {
     stream->print(";; ");
     OutputVector(stream,n,v);
     stream->println();
   }
}


/*

Our coal here is implement a "driver" for the 6-controller PCB board
that I designed.  Ideally this driver willl be usable for any gneral
purpose need to control 6 motors.  However, I am personally focused on
controlling 6 Firgelli Actuators in my Gluss robot.  So at the time of
this writing this is probably slanted for this purpose, and in fact
the board interfaces better to the Firgelli actuator hardware device,
which uses potentiometers to return position, than to generaly rotary
motors, although if you ignore that and use only the voltage wires,
you can control DC rotary motors.

There are various functions which exist purely for testing:

"small" - contract as much as possible
"relax" - relax (to middle position) as much as possible
"big" - expand as much as possible
"halt" - stop any current move immediately

"(m a0 a1 a2 a3 a4 a5)" -- Move to these positions.

Status commands:
"status" - return the positional vector of all actuators (this should be
expanded to return the functional status of all acutators as well, but
that is for the future)

"a" - attempt to determine which actuators are functional or not

 */

/*
This function accepts Strings of the form "(m D+ D+ D+ D+ D+ D+)".
(Where the number of digits is equal to the number of Acutators.)
Exactly like that, no extra sapces.  Yes, it is a lisp form, but don't
be fooled --- I have not yet implemented a full parser, and won't until
I have a use-case driving it.

 */
String get_function_symbol(String str) {
  if (str[0] != '(') {
    return "error";
  } else {
    int in = str.indexOf(' ');
    if (in != 2) {
      return "error";
    } else {
      return str.substring(1,2);
    }
  }
}
int nth_number(String str,int n) {
  int pos = 0;
  pos = str.indexOf(' ',pos)+1;
  for (int i = 0; i < n; i++) {
    pos = str.indexOf(' ',pos)+1;
  }
  int spos = (n != 5) ? str.indexOf(' ') : str.indexOf(')');
  int val = str.substring(pos,spos).toInt();
  return val;
}


void interpret_function_as_sepxr(Stream *debug,String str) {

  log_comment(INFORM,debug,"interpreting:");
  log_comment(INFORM,debug,str);
  // Note that parse needs a "char const *" that should not be changed.
  int len = str.length();

  // Note this is a stack-allocated char *
  char buffer[len+1];

  
  str.toCharArray(buffer,len+1);


  log_comment(DEBUG,debug,"buffer");
  log_comment(DEBUG,debug,buffer);
  
  sexpr* s = parse(buffer);
  // If 0th element is atom, we treat as funciton.
  // if list, we treat it as (function symbol)) pair, and
  // return symbol when we give back commands associated with this.
  // We in theory could implement Arduino multi-tasking and
  // report different gensyms asynchronously, but we will
  // pretend that this controller is only processing one command
  // synchronously at a time now, so we an use a global for the symbol

  sexpr* first = nth(s,0);
  String fun;
  String call_symbol;

  log_comment(DEBUG,debug,"parsed as:");
  log_comment(DEBUG,debug,print_as_String(s));
  log_comment(DEBUG,debug,print_as_String(first));
  

  command_failure = "";

  if (first->tp == CONS_T) {
    fun = value_s(first->car);
    call_symbol = value_s(nth(first,1));
    // now call_sym
    Current_Call_Id = call_symbol;
    log_comment(INFORM,debug,"Setting Currrent_call_ID");
    log_comment(INFORM,debug,Current_Call_Id);
  } else if (first->tp == STRING_T) {
    fun = value_s(first);
    Current_Call_Id = "";
  } else {
    log_comment(PANIC,debug,"BAD FORM FOR COMMAND, MUST BE STRING of (FUN SYM) form");
    String echo = print_as_String(s);
    log_comment(PANIC,debug,echo);
    command_failure = str;
  }

  log_comment(INFORM,debug,"fun from s-Expression =");
  log_comment(INFORM,debug,fun);
  if (fun.equals("get-status")) {
    log_comment(INFORM,debug,"About to get status");
    report_status(debug,Current_Call_Id);
    log_comment(INFORM,debug,"Done with status.");
  } else if (fun.equals("relax")) {
    relax(debug);
    log_comment(INFORM,debug,"done with Relax.");
   } else if (fun.equals("big")) {
    expand(debug);
    log_comment(INFORM,debug,"done with Expand.");
   } else if (fun.equals("small")) {
    contract(debug);
    log_comment(INFORM,debug,"done with Contract.");
  } else if (fun.equals("halt")) {
    if (t2.isEnabled()) {
      t2.disable();
      for(int i = 0; i < mvps.n; i++) {
        deactivate_actuator(i);
      }
      report_status(debug,mvps.Current_Call_Id);
    }
    log_comment(INFORM,debug,"done with halt.");
    report_status(debug,Current_Call_Id);
  } else if (fun.equals("responsive")) {
    find_responsive(debug);
    log_comment(INFORM,debug,"done with Calculate.");
    report_status(debug,Current_Call_Id);
   } else if (fun.equals("debug-level")) {
    sexpr* args = s->cdr;
    sexpr* sub = nth(args,0);
    int level = value_i(sub);
    log_comment_i(PANIC,debug,level);    
    DEBUG_LEVEL = level;   
    log_comment(PANIC,debug,"done-with debug-level, set to:");
    log_comment_i(PANIC,debug,level);
    report_status(debug,Current_Call_Id);
   } else if (fun.equals("m")) {
    int ps[NUM_ACTUATORS];
    for(int i = 0; i <  NUM_ACTUATORS; i++) {
      ps[i] = value_i(nth(s,(i+1)));
    }
    // Now we invoke the "m" function, or movement....
    move_vector(debug,NUM_ACTUATORS,ps,Current_Call_Id);
  } else if (fun.equals("p")) {

    // First, fill out the position vector...
    int ps[NUM_ACTUATORS];
    sensePositionVector(NUM_ACTUATORS,ps);
    log_comment(INFORM,debug,"Here are the position that we sense:");
    OutputVectorAsComment(INFORM,debug,NUM_ACTUATORS,ps);

    // now read each sublist to change the positions....
    String full = print_as_String(s);
    log_comment(INFORM,debug,full);

    sexpr* args = s->cdr;
    int len = s_length(args);
    for(int i = 0; i <  len; i++) {
      sexpr* sub = nth(args,i);
       int ji = value_i(nth(sub,0));
       int vi = value_i(nth(sub,1));
      ps[ji] = vi;
     }
    move_vector(debug,NUM_ACTUATORS,ps,Current_Call_Id);
  } else if (fun.equals("set-activation")) {
    // a zero values means make inactive, a non-zero means active
    // now read each sublist to change the positions....
    String full = print_as_String(s);
    log_comment(PANIC,debug,full);

    sexpr* args = s->cdr;
    int len = s_length(args);
    for(int i = 0; i <  len; i++) {
      sexpr* sub = nth(args,i);
       int ji = value_i(nth(sub,0));
       int vi = value_i(nth(sub,1));
       act[ji].responsive = (vi != 0);
     }
  } else {
    log_comment(PANIC,debug,"Don't know how to handle:");
    log_comment(PANIC,debug,str);
    command_failure = str;
    report_status(debug,Current_Call_Id);
  }
  del(s);
  // We still want to report status here no matter what happens
  // so the controller knows that we are done.

}


void main_controller(Stream* debug,String str) {
  interpret_function_as_sepxr(debug,str);
}


Scheduler runner;

//void main_controller_callback() {
//  if (gparam_for_sexpr_callback_str.length() != 0) {
//    interpret_function_as_sepxr(gparam_for_sexpr_callback_debug,gparam_for_sexpr_callback_str);
//    gparam_for_sexpr_callback_str = EMPTY_STRING;
//  } else {
//
//  }
//}

// This isn't really much of a task ... this is more a test of functionality...
unsigned long lastTime;
char temp_buffer[1024];
char ring_buffer[1024];
int ring_init = 0;
int ring_finl = 0;
int ring_len = 0;
void input_check_callback() {
    unsigned long StartTime = millis();
  //  log_comment_i(WARN,&bluetooth,lastTime - StartTime);
    lastTime = StartTime;  

    r_cnt++;
  if(bluetooth.available()>0)  // If the bluetooth sent any characters
    {
      int x = bluetooth.available();
  //    Serial.println("x = ");
  //    Serial.println(x);

        unsigned long StartTime = millis();
      bluetooth.setTimeout(10);
      int n = bluetooth.readBytes(temp_buffer,1024);
           unsigned long EndTime = millis();
    //  Serial.println(n);
      bool eoln_found = false;
      int line_len;
      if (n + ring_len >= 1024) {
        log_comment(PANIC,&bluetooth,"BUFFER OVERFLOW");
        Serial.print("BUFFER OVERFLOW");
      }
      for(int i = 0; i < n; i++) {
        char c = temp_buffer[i];
        
         ring_buffer[(i+ring_init) % 1024] = c;
      }
      ring_finl = (ring_init+n) % 1024;
      ring_len += n;
 
    //  Serial.println("XXXX");
    //  Serial.println(EndTime-StartTime);
    }
  int line_len = 0;
  for(int i = 0; i < ring_len && line_len == 0; i++) {
      char c = ring_buffer[(i+ring_init) %1024];
      if (c == '\n') {
           line_len = i;
      }
  }
  // At htis point line_len is content + 1 for the eoln...
  // if (line_len != 0)
   // Serial.println(line_len);
// a positive line_len means we have found a line to process..
   if (line_len > 0) {
      char str_buff[line_len+1];
       for(int i = 0; i < line_len; i ++) {
          str_buff[i] = ring_buffer[(i+ring_init) % 1024];
        }
        str_buff[line_len] = '\0';
        ring_init += (line_len);
        ring_init = ring_init % 1024;
        ring_len -= (line_len);
        // If we have found the end of line, we want to copy things out of the 
        // ring buffer and into the temp_buffer to create a String object...
   
      String str = String(str_buff);
      str.trim();
    
      // Send any characters the bluetooth prints to the serial monitor
      gparam_for_sexpr_callback_debug = &bluetooth;

      // The act of making this non-null activates our task that should run the main loop...
      gparam_for_sexpr_callback_str = str;
      if (gparam_for_sexpr_callback_str.length() != 0) {
         interpret_function_as_sepxr(gparam_for_sexpr_callback_debug,gparam_for_sexpr_callback_str);
         gparam_for_sexpr_callback_str = EMPTY_STRING;
    } else {

    }
   }
//      runner.addTask(t1);
//     t1.enable();
//      main_controller(&bluetooth,str);    }
  if(Serial.available()>0)  // If stuff was typed in the serial monitor
    {
      // Send any characters the Serial monitor prints to the bluetooth
      String s =  Serial.readStringUntil('\n');
      bluetooth.println(s);
       Serial.println("Serial port read");
      Serial.println(s);
    }
}


void loop()
{
  runner.execute();
}
void SetUpActuator(int i,actuator* a);

void setup()
{
  // It is possible that this is a real problem for battery powered operation!!!!
  Serial.begin(9600);  // Begin the serial monitor at 9600bps
  Serial.println("Serial port ready!");
  

  bluetooth.begin(115200);  // The Bluetooth Mate defaults to 115200bp
  
  bluetooth.print("$");  // Print three times individually
  bluetooth.print("$");
  bluetooth.print("$");  // Enter command mode
  delay(100);  // Short delay, wait for the Mate to send back CMD
  String c_atom1 = "U,";
  String c_atom2 = ",N";
  String commandString = String(c_atom1+BLUETOOTH_BAUD_RATE_STRING+c_atom2);
  bluetooth.println(commandString);  // Temporarily Change the baudrate to 9600, no parity
  // 115200 can be too fast at times for NewSoftSerial to relay the data reliably
  
  bluetooth.begin(BLUETOOTH_BAUD_RATE);
  
  Serial.println("XXX!");

  log_comment(PANIC,&bluetooth,"Alive and listening");

  for(int i = 0; i < NUM_ACTUATORS; i++) {
    SetUpActuator(i,&(act[i]));
  }
  
  for(int i = 0; i < NUM_ACTUATORS; i++) {
    pinMode(54+i,INPUT);
  }
  
  // Make sure the PWM pins are set to output for controlling speed.
  for(int i = 2; i < 9; i++) {
    pinMode(i,OUTPUT);
  }
  
  for(int i = 0; i < 4 * 5; i++) {
    pinMode(34+i,OUTPUT);
  }
  
  Serial.println("Setup done!");
  //  find_responsive(&Serial);
  // Now lets just put something into place to allow us to remark them unresponsive...

  // Now we will try to setup the tasks....
  gparam_for_sexpr_callback_debug = &bluetooth;
  runner.init();
  runner.addTask(t0);
  t0.enable();
  //runner.addTask(t1);
 // t1.enable();
  runner.addTask(t2);
  t2.disable();
}

void SetUpActuator(int i,actuator* a) {
  a->forwardPin = 53 - 2*i;
  a->reversePin = a->forwardPin - 1;
    
  // In the Arduino Mega, the Anaglog pins A0, A1, etc, are numbered 54,55, etc.
  a->speedPin = 2+i;
  a->potPin = 54+i;
  a->nm = 'a' + i;
  a->minV = 0;
  a->maxV = 1023;
  a->responsive = 1;    
}
