PubInv/tetrobot/(commit log)

2015-12-17 initial code for Arduino Mega
2016-01-13 more robust code to handle failing actuators
2016-03-01 Adding latest driver file, Makefile, Emacs Lisp control file, and bracket 3D printer files
    [BatteryCase.stl, CaseBracket.stl, EnclosureLid.stl, EnclosureWithShield.stl, LidWPort.stl, Try2.stl, firg-flexbatter.scad, firg-flexbatter.stl]
2016-03-02 initial debug version of lisp interpreation of arduino output working
2016-03-07 working through bug in value_i in S-Expr
    [GlussPCBv0.1.ino]
2016-03-10 adding .gitignore for Arduino complilation
2016-03-11 adding scad
    [firg-flexbatter2.scad]
2016-03-11 new battery holder, first draft
    [NiMhHolder.stl]
2016-03-11 lots of movement but not walking, electronically buggy
    [GlussPCBv0.1.ino]
2016-03-17 Forgot to actualy call del, now fixed!
    [GlussPCBv0.1.ino]
2016-04-12 updating before move to gh-pages
    [NiMhHolder.stl, firg-flexbatter2.scad]
2016-04-16 adding Eagle Files
    [Mega_Shield-v13-VertPlace7.brd, Mega_Shield-v13-VertPlace7.sch]
2016-05-04 adding enclosures
    [arduino-enclosure.scad]
2016-07-09 got actuator mapping stuff done
2016-07-14 new actuator numbering scheme
2016-07-20 broadwalk at 2.5mm/s
2016-07-21 additions of battery/arduino enclusure
    [combined_enclosure.stl]
2016-07-21 adding combined_enclosure
    [combined_enclosure.scad]
2016-07-28 combined enclosure
    [combined_enclosure.scad]
2016-09-19 moving button
2016-09-19 moving button again
2016-10-28 allowing named poses to be reached as buttons
2016-12-10 continued progress switching to AMMO, but terrible bugs remaining
2016-12-13 jitter much better with sphere, but apparently no damping or friction on objects
2016-12-13 minor fix to camera
2017-02-02 continuous helix for each rail worked out
2017-03-18 finally got the interactive time down to less than 500 milliseconds
2017-03-23 obsolete but updating
    [firg-flexbatter2.scad]
