PubInv/tetrobot/(notices)

Notices in the files:
GlussPCBv0.1/Mega_Shield-v13-VertPlace7.brd:
Creative Commons BY-NC-SA 4.0
parts and their libraries:
SparkFun-Connectors: Licensing: Creative Commons ShareAlike 4.0 International - https://creativecommons.org/licenses/by-sa/4.0
